makerbot/Stepstruder-MK7/README

This is the MakerBot Industries Stepstruder MK7.

http://store.makerbot.com/stepstruder-mk7-complete-stepper.html
