makerbot/Stepstruder-MK7/nema17-33mm.SLDPRT

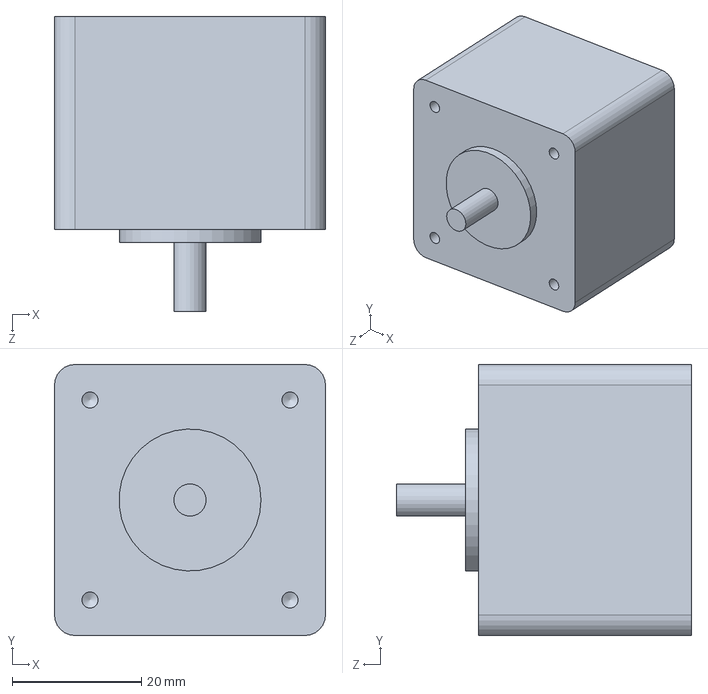
[picture p1: CAD file, 2011-09-20]
nema17-33mm.SLDPRT
42.0 x 42.0 x 45.7 mm
