makerbot/Stepstruder-MK7/MP1711-MK7-Fan-40x40x10.SLDPRT

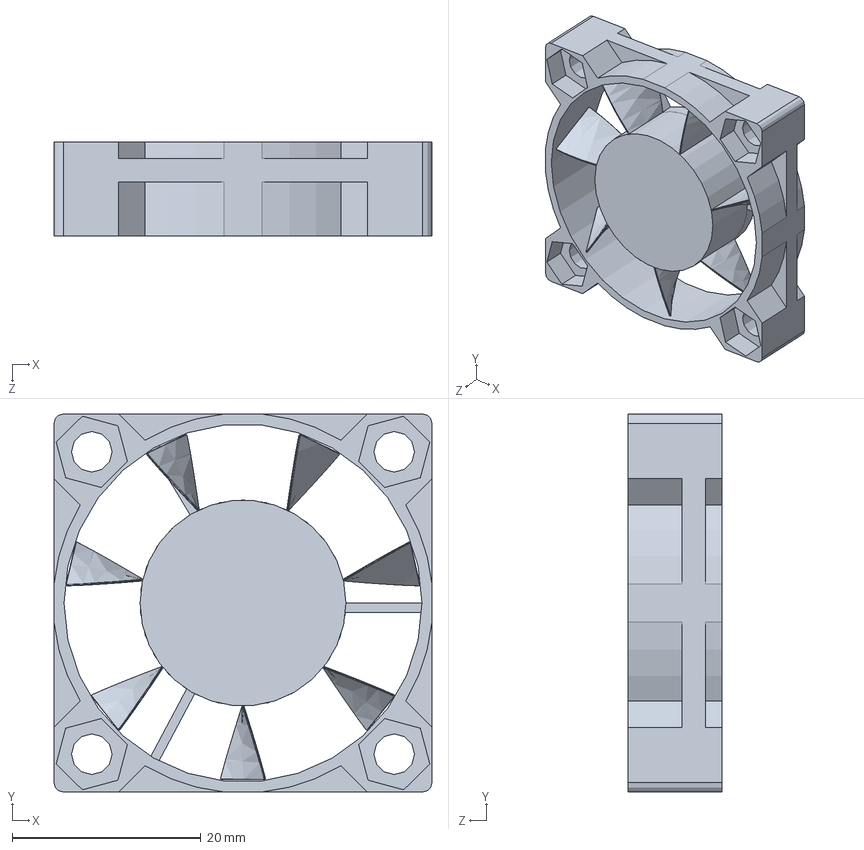
[picture p2: CAD file, 2011-09-20]
MP1711-MK7-Fan-40x40x10.SLDPRT
40.0 x 40.0 x 10.0 mm
