makerbot/Stepstruder-MK7/MP1704-MK7-Drive-Gear.SLDPRT

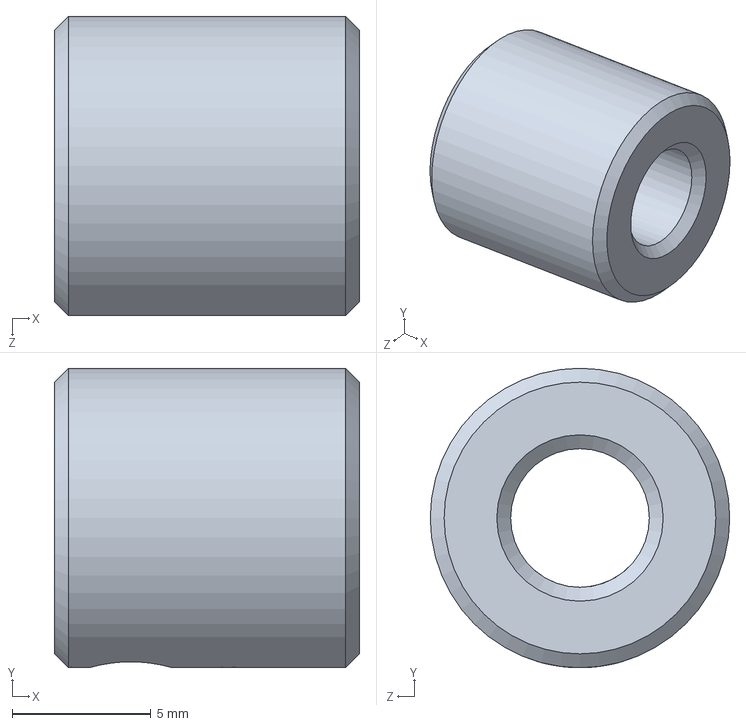
[picture p3: CAD file, 2011-09-20]
MP1704-MK7-Drive-Gear.SLDPRT
11.0 x 10.8 x 10.8 mm
