makerbot/Stepstruder-MK7/MP1794-MK7-Filament-Drive-Block-Front.sldprt

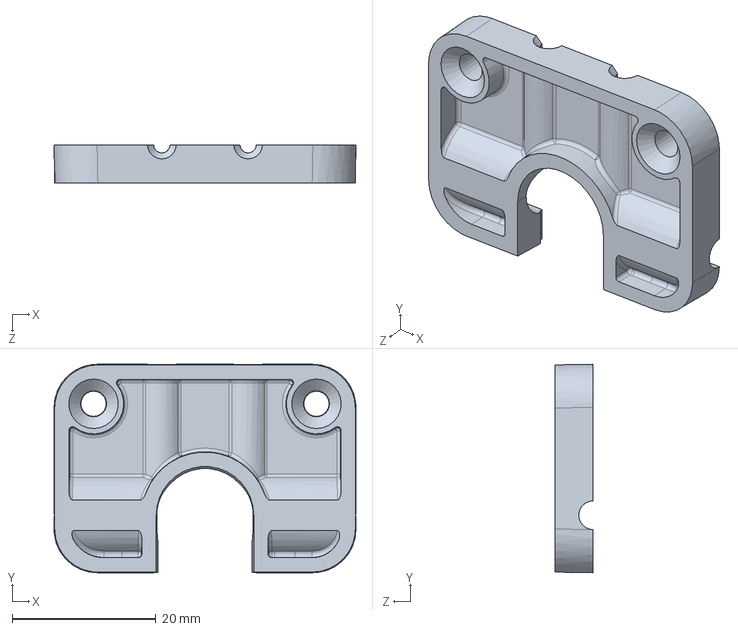
[picture p4: CAD file, 2011-09-20]
MP1794-MK7-Filament-Drive-Block-Front.sldprt
42.0 x 29.0 x 5.35 mm
