makerbot/Stepstruder-MK7/w40-15.SLDPRT

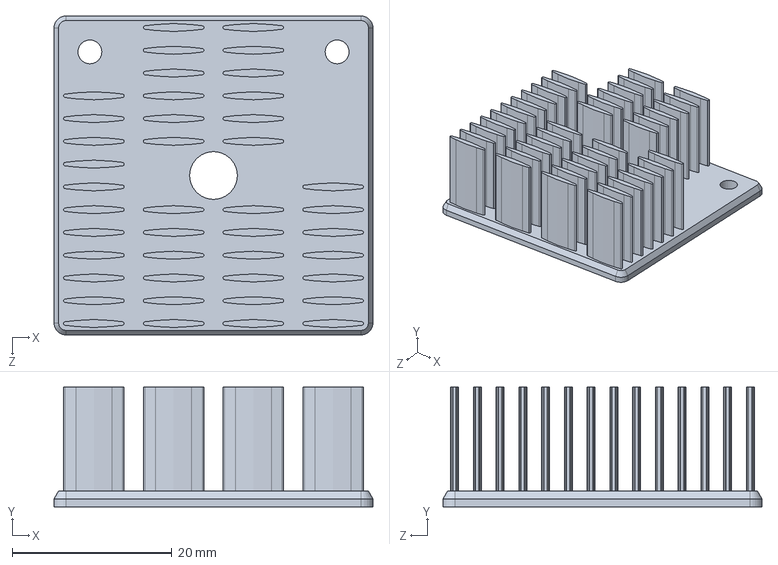
[picture p5: CAD file, 2011-09-20]
w40-15.SLDPRT
40.0 x 15.0 x 40.0 mm
