makerbot/Stepstruder-MK7/MP1701-MK7-Thermal-Barrier.SLDPRT

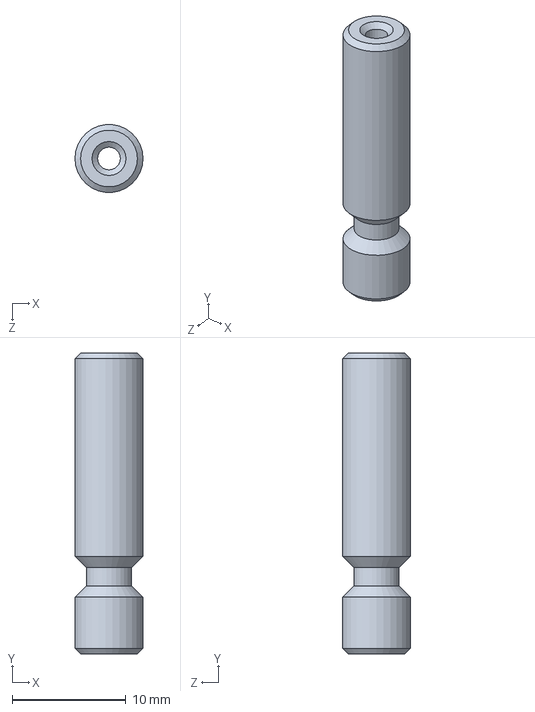
[picture p6: CAD file, 2011-09-20]
MP1701-MK7-Thermal-Barrier.SLDPRT
6.00 x 26.5 x 5.97 mm
