makerbot/Stepstruder-MK7/MP1700-MK7-Bar-Mount.SLDPRT

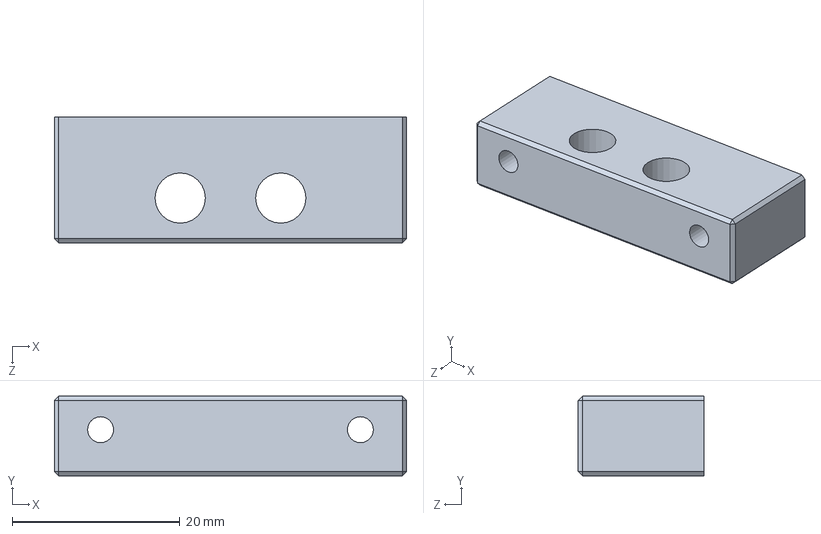
[picture p7: CAD file, 2011-09-20]
MP1700-MK7-Bar-Mount.SLDPRT
42.0 x 9.50 x 15.0 mm
