makerbot/Stepstruder-MK7/MP1702-MK7-nozzle.SLDPRT

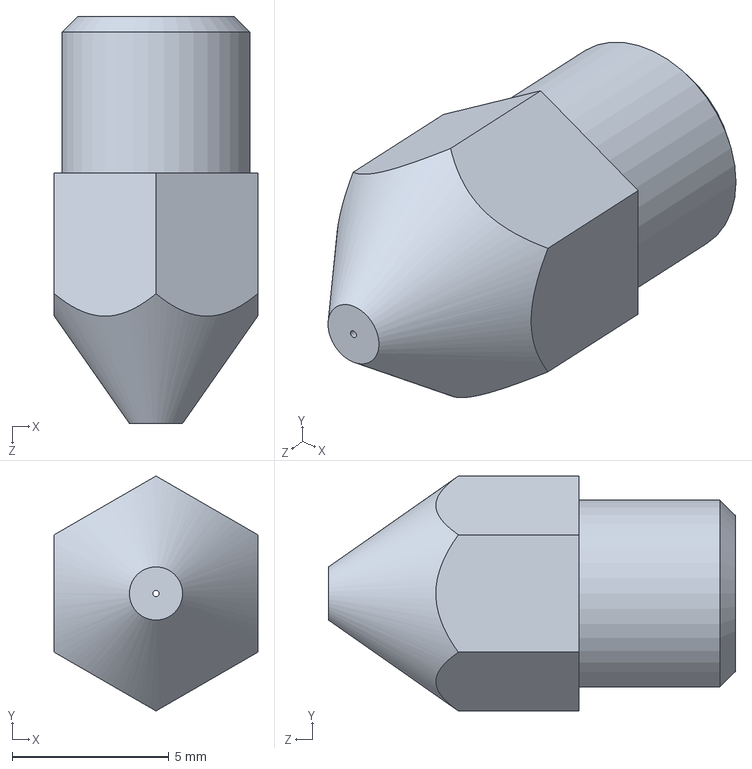
[picture p8: CAD file, 2011-09-20]
MP1702-MK7-nozzle.SLDPRT
6.50 x 7.51 x 13.0 mm
