makerbot/Stepstruder-MK7/MP1705-MK7-Thermal-Core.sldprt

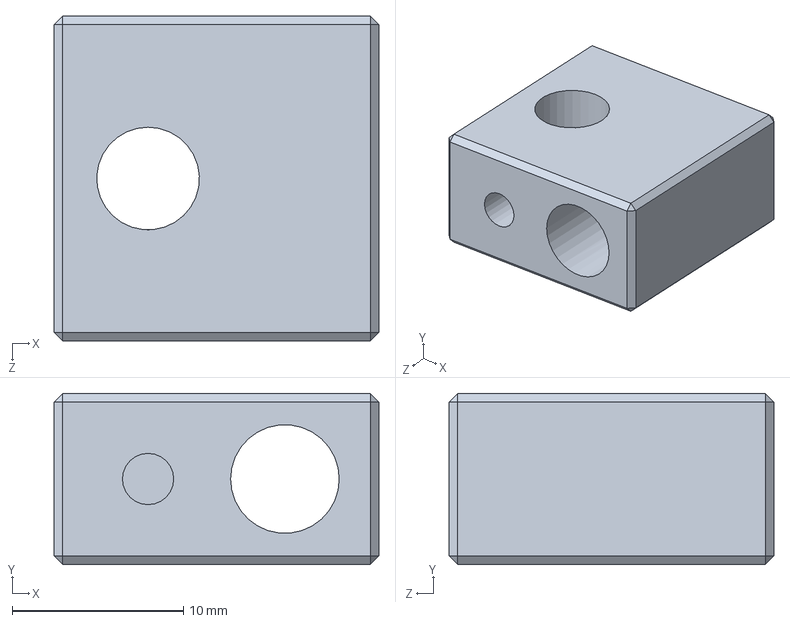
[picture p9: CAD file, 2011-09-20]
MP1705-MK7-Thermal-Core.sldprt
19.0 x 10.0 x 19.0 mm
