makerbot/Stepstruder-MK7/z-stage.SLDPRT

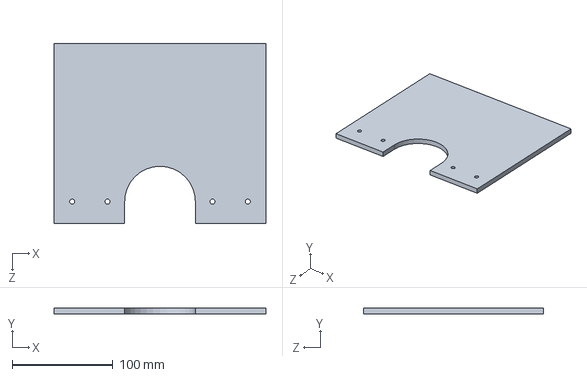
[picture p10: CAD file, 2011-09-20]
z-stage.SLDPRT
210.0 x 6.00 x 178.4 mm
