makerbot/Stepstruder-MK7/spring-9435K350.SLDPRT

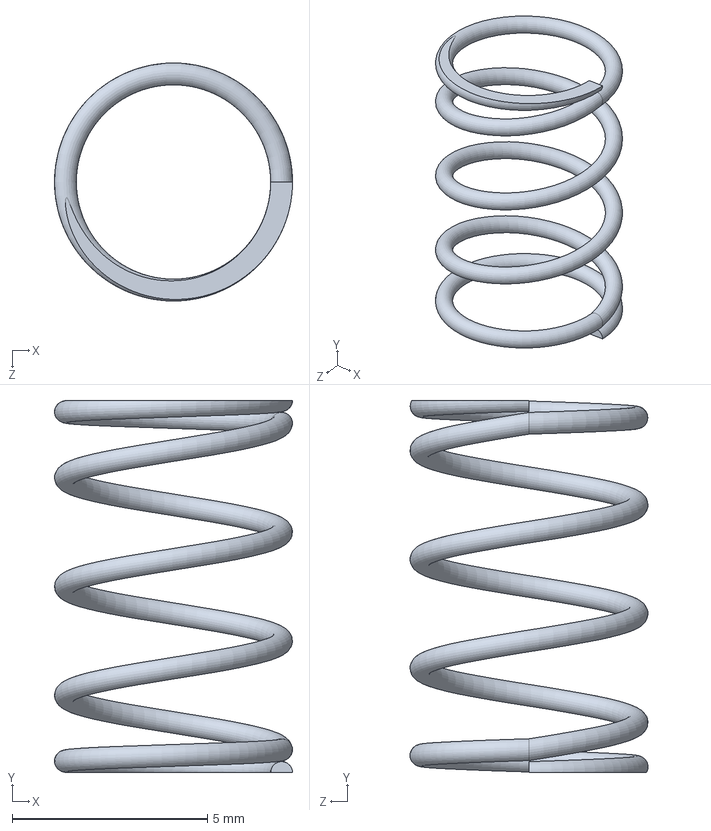
[picture p11: CAD file, 2011-09-20]
spring-9435K350.SLDPRT
6.10 x 9.53 x 6.10 mm
