makerbot/Stepstruder-MK7/MP1582-Cartridge-Heater.SLDPRT

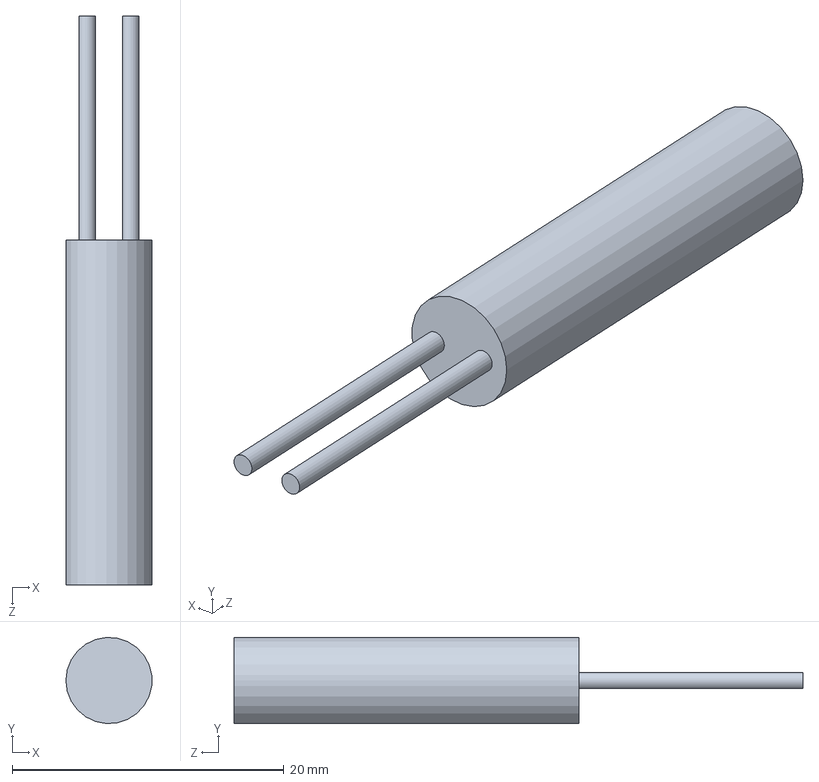
[picture p12: CAD file, 2011-09-20]
MP1582-Cartridge-Heater.SLDPRT
6.35 x 6.34 x 41.9 mm
