makerbot/Stepstruder-MK7/MP1703-MK7-Filament-Drive-Block-Back.sldprt

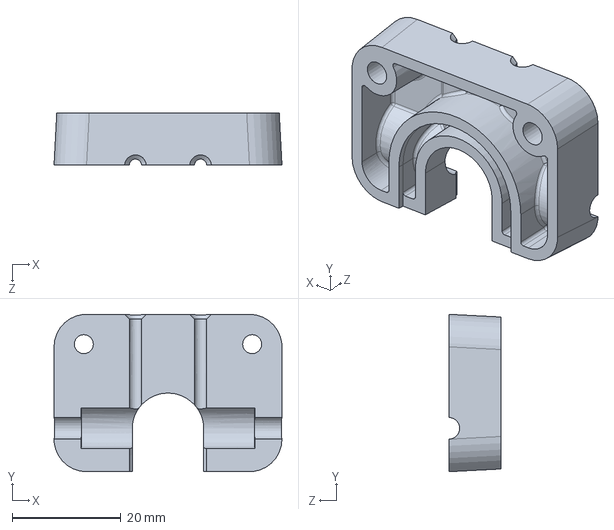
[picture p13: CAD file, 2011-09-20]
MP1703-MK7-Filament-Drive-Block-Back.sldprt
42.0 x 29.0 x 9.65 mm
