makerbot/Stepstruder-MK7/MP1701-MK7-Thermal-Barrier-RevB.SLDPRT

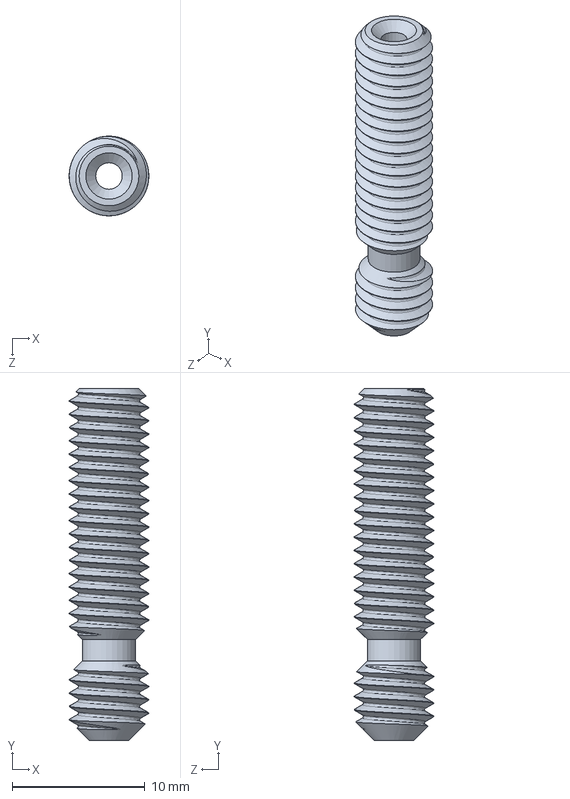
[picture p14: CAD file, 2011-09-20]
MP1701-MK7-Thermal-Barrier-RevB.SLDPRT
6.00 x 26.5 x 6.00 mm
