makerbot/Stepstruder-MK7/MP1707-MK7-Plunger.SLDPRT

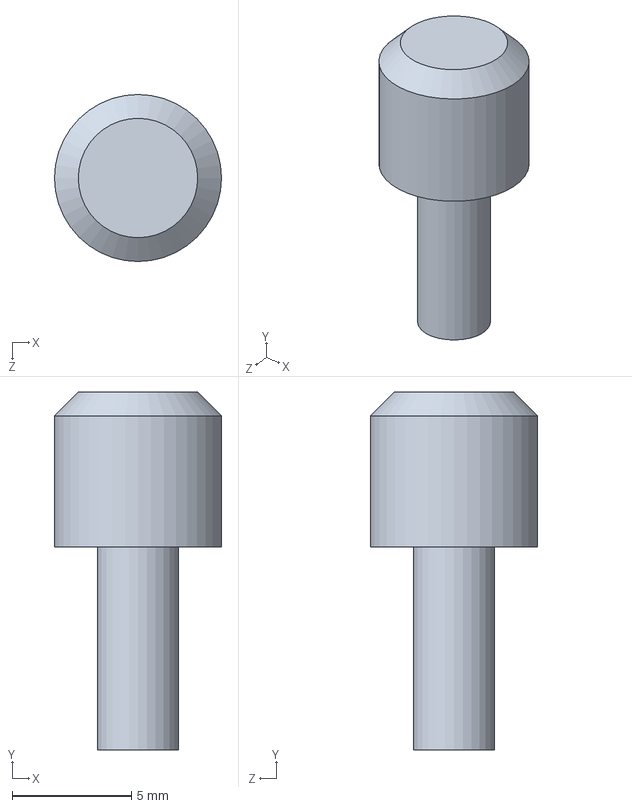
[picture p15: CAD file, 2011-09-20]
MP1707-MK7-Plunger.SLDPRT
7.00 x 15.0 x 7.00 mm
