makerbot/Stepstruder-MK7/MP1714-MK7-mounting-plate.SLDPRT

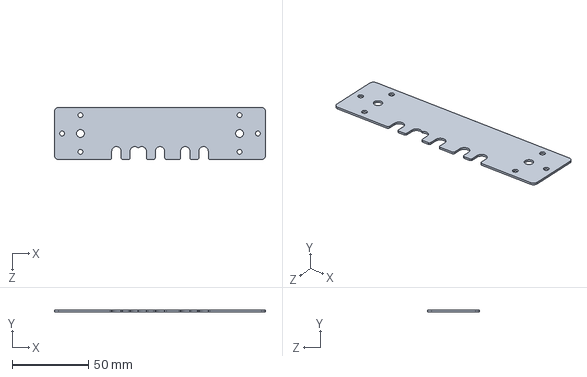
[picture p16: CAD file, 2011-09-20]
MP1714-MK7-mounting-plate.SLDPRT
138.0 x 1.11 x 34.0 mm
