makerbot/Stepstruder-MK7/MP1771-MK7-Support.SLDPRT

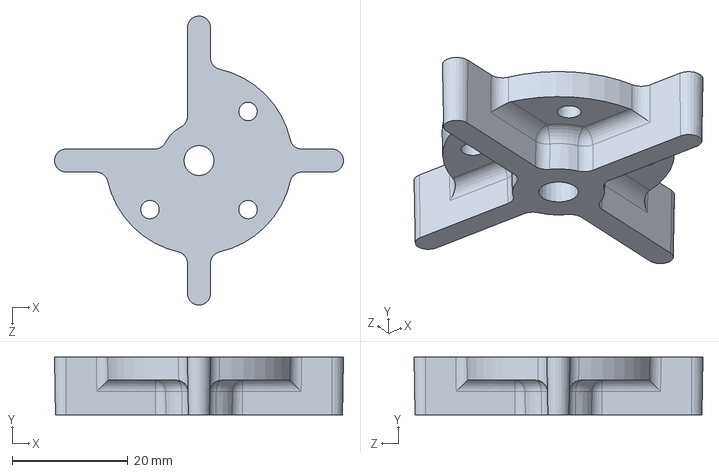
[picture p17: CAD file, 2011-09-20]
MP1771-MK7-Support.SLDPRT
50.0 x 10.0 x 50.0 mm
