makerbot/Stepstruder-MK7/thermal-cutoff.SLDPRT

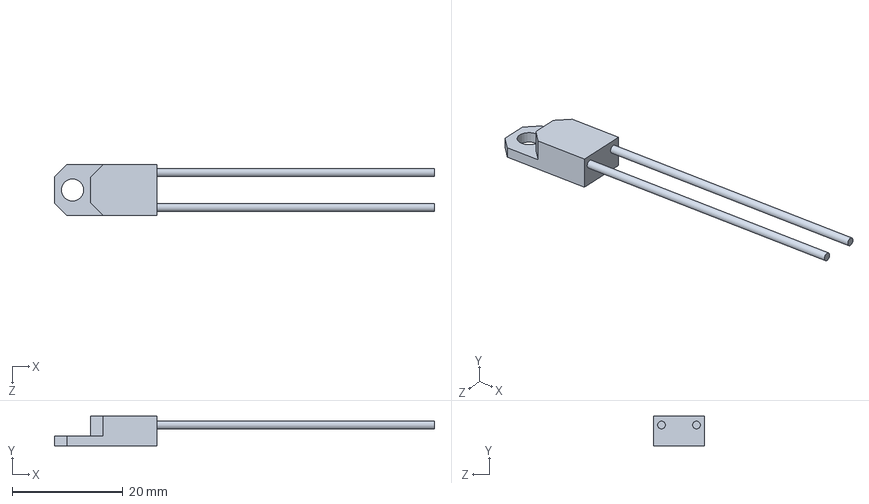
[picture p18: CAD file, 2011-09-20]
thermal-cutoff.SLDPRT
68.5 x 5.40 x 9.20 mm
