makerbot/Stepstruder-MK7/filament-drive-block.SLDPRT

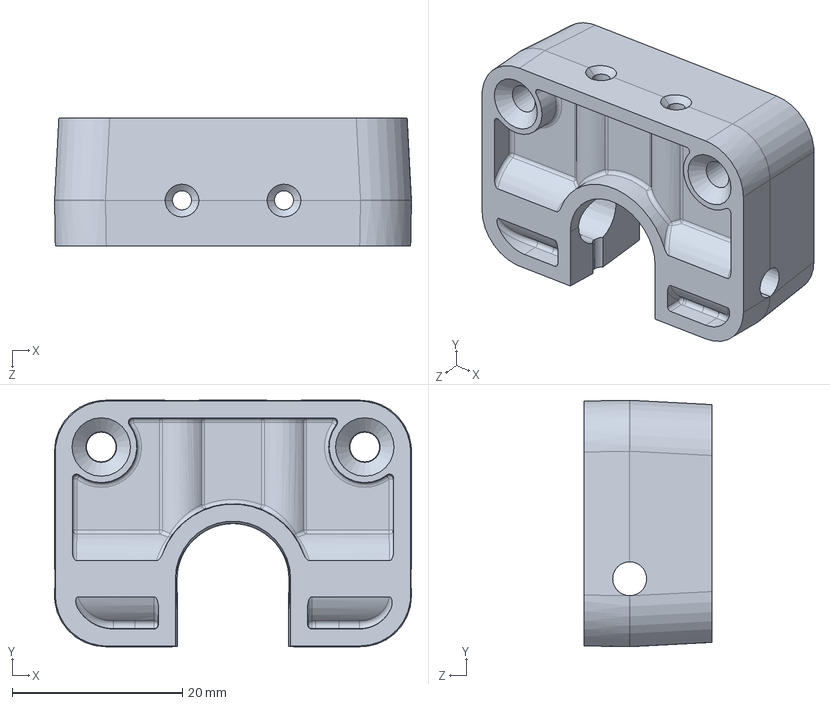
[picture p19: CAD file, 2011-09-20]
filament-drive-block.SLDPRT
42.0 x 29.0 x 15.0 mm
