makerbot/Stepstruder-MK7/(list of files, cad)

Other CAD files:
MP1701-MK7-Thermal-Barrier-RevB.SLDDRW
MP1701-MK7-Thermal-Barrier-RevB.STL
MP1714-MK7-mounting-plate-RevB.SLDDRW
m3-nut-90591A121.SLDPRT
m3-washer-91100A120.SLDPRT
m3x12-socket-cap-91290A117.SLDPRT
m3x22-socket-cap-91290A124.SLDPRT
m3x3-set-screw-91390A097.SLDPRT
m3x5-socket-cap-91290A124.SLDPRT
m5-nut-90591A146.SLDPRT
m5x20-socket-cap-91290A242.SLDPRT
m6-thin-nut-90695A038.SLDPRT
m6x10-socket-cap-low-profile-93070A141.SLDPRT
