makerbot/Stepstruder-MK7/MP1701-MK7-Thermal-Barrier-RevB.PDF

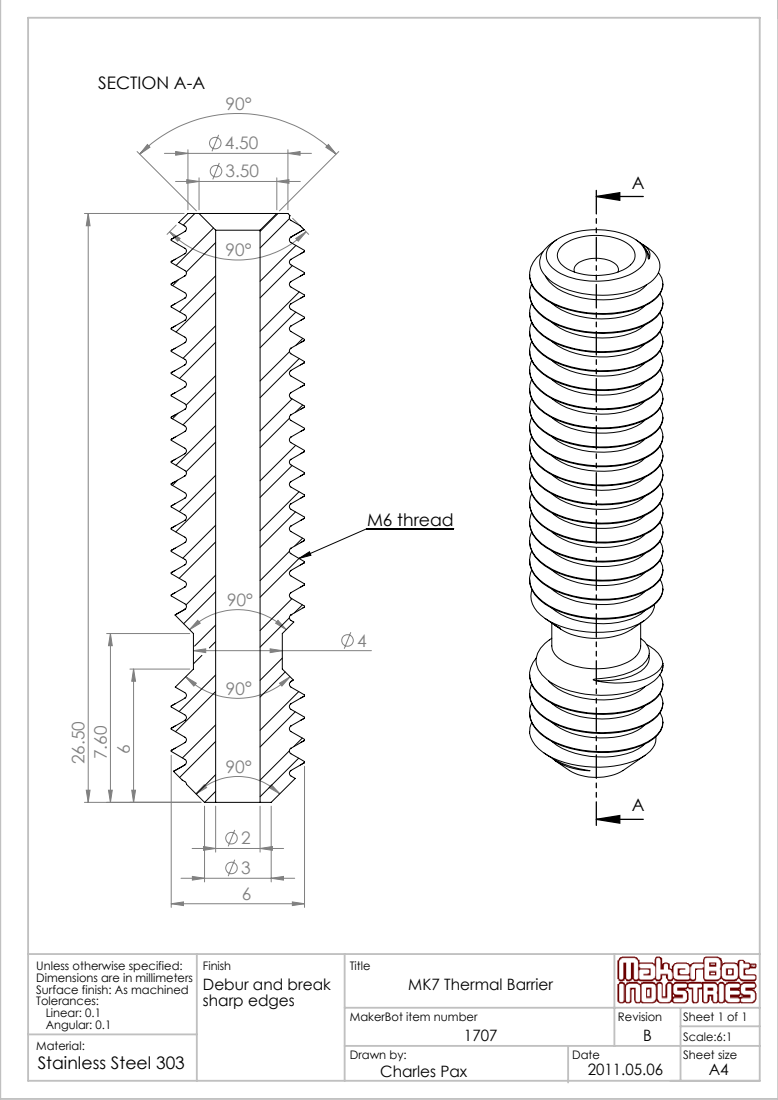
[picture p20: page 1]
SECTION A-A; M6 thread; Sheet size; Charles Pax; Drawn by:; Stainless Steel 303

Unless otherwise specified: Dimensions are in millimeters Surface finish: As machined Tolerances: Linear: 0.1 Angular: 0.1 | Finish Debur and break sharp edges | Title MK7 Thermal Barrier

MakerBot item number 1707 | Revision B | Sheet 1 of 1
