makerbot/Stepstruder-MK7/MP1714-MK7-mounting-plate-RevB.PDF

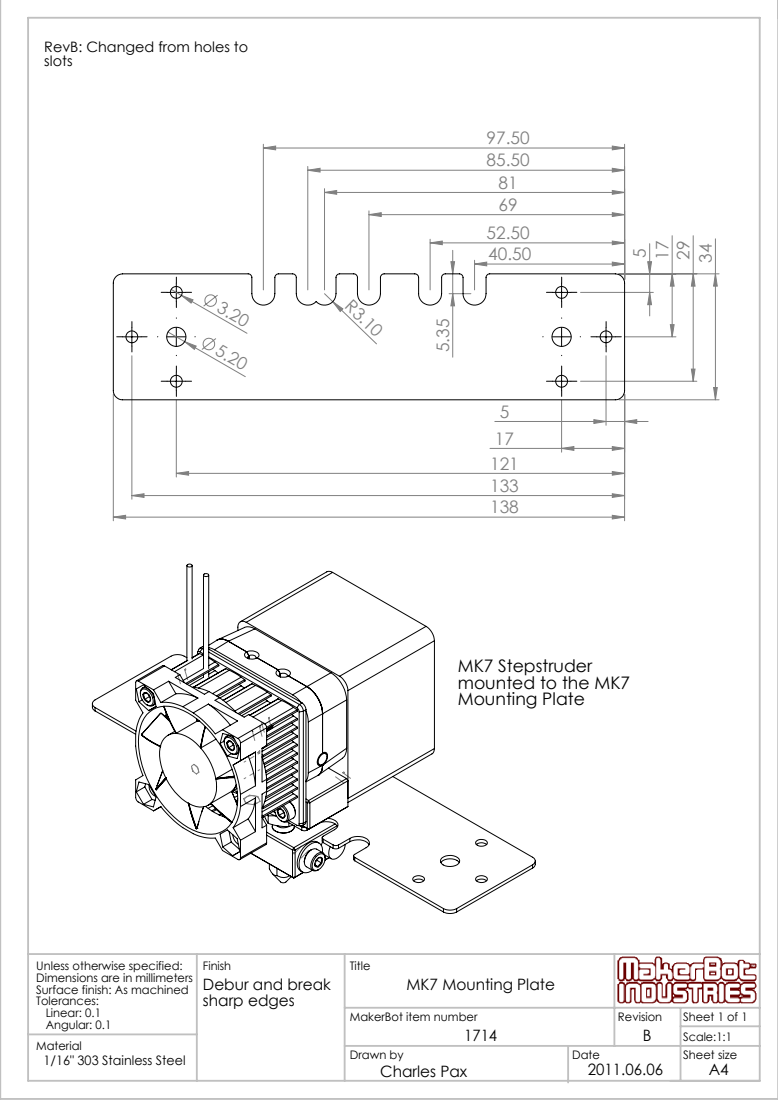
[picture p21: page 1]
Sheet size; Charles Pax

RevB: Changed from holes to
slots

MK7 Stepstruder
mounted to the MK7
Mounting Plate

Unless otherwise specified: Dimensions are in millimeters Surface finish: As machined Tolerances: Linear: 0.1 Angular: 0.1 | Finish Debur and break sharp edges | Title MK7 Mounting Plate Drawn by 1/16" 303 Stainless Steel

MakerBot item number 1714 | Revision B | Sheet 1 of 1
